naturewind846/CheapPcbPaddleKey/(list of files, drawings)

Other design files:
ProPrj_磁回弹自动pcb电键_2024-10-03.epro
