naturewind846/CheapPcbPaddleKey/(commit log)

2024-08-31 Add files via upload
    立创eda专业版的项目文件
    [磁回弹自动pcb电键_2024-08-31.epro]
2024-08-31 立创eda项目文件
    [磁回弹自动pcb电键_2024-08-31.epro]
2024-09-09 立创eda专业版项目文件
    [磁回弹自动pcb电键_2024-09-09.epro]
2024-09-09 立创eda专业版工程文件
    [磁回弹自动pcb电键_2024-09-09.epro]
2024-09-18 立创eda专业版工程文件
    NOT Gerber
    [磁回弹自动pcb电键_2024-09-19.epro]
